MilanFostier1/Linefollower/technische tekeningen/mechanisch/Foto PCB 3D Bottom.png

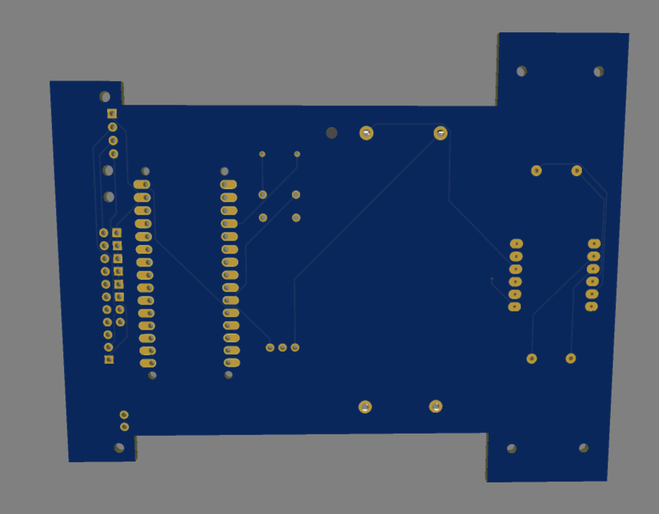
technische tekeningen/mechanisch/Foto PCB 3D Bottom.png
