MilanFostier1/Linefollower/technische tekeningen/mechanisch/Foto PCB 3D Top.png

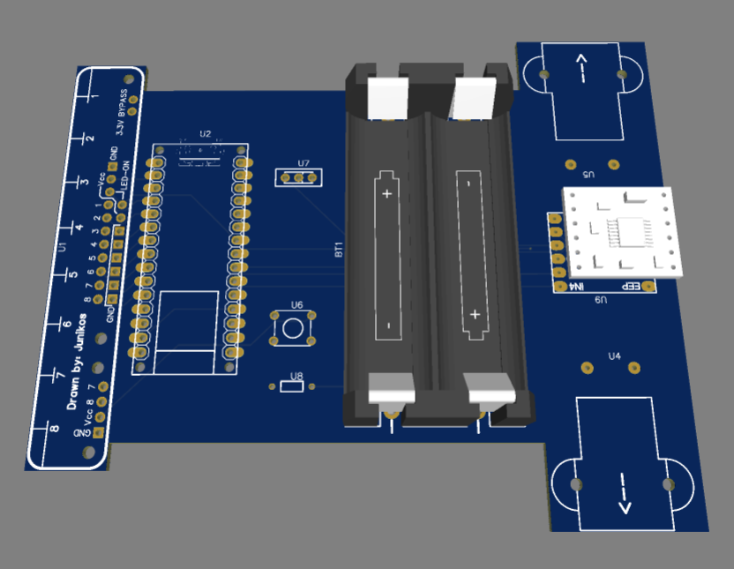
technische tekeningen/mechanisch/Foto PCB 3D Top.png
