MilanFostier1/Linefollower/bill of materials/readme.md

## bill of materials
<br />

|volgnummer|naam|omschrijving|nieuw/recup|kostprijs/stuk|aantal|subtotaal|
|---|----|---|---|---|---|---|
| 1 | Arduino® Nano ESP32 | Microcontroller | nieuw | €21.00 | 1 | €21.00 |
| 2 | DC motoren | 50:1 Micro Metal Gearmotor HP 6V | nieuw | €20.70 | 2 | €41.40 |
| 3 | Li-ion batterijen | 18650 Li-ion Oplaadbare Batterijen - 2200mAh 3.7V | nieuw | €12.68 | 2 | €25.36 |
| 4 | DRV8833 | H-brug | nieuw | €3.00 | 1 | €3.00 |
| 5 | QTR-8A | Sensor | nieuw | €11.19 | 1 | €11.19 |
| 6 | Wielen | Pololu Wheel 40×7mm Pair – Black | nieuw | €4.71 | 2 | €9.42 |
| 7 | Batterijhouder | 2 Slot Dubbele Serie 18650 Batterijhouder 7.4V DC | nieuw | €7.80 | 1 | €7.80 |
| 8 | Chassis | Experimenteer Prototyping Printplaat 9x15cm groen | nieuw | €2.25 | 1 | €2.25 |
| 9 | Batterijoplader | 2-Slots Batterijoplader 2x 18650 Oplaadbare Batterijen | nieuw | €10.69 | 1 | €10.69 |
| 10 | DC motoren beugel | Pololu Micro Metal Gearmotor Bracket Pair - Black | €nieuw | €2.54 | 1 | €2.54 |
| 10 | Draad | 40-aderig 2.54mm 28AWG Dupont per meter | nieuw | €3.90 | 1 | €3.90 |
| 11 | Schuifschakelaar | Schuifschakelaar SS12D00G2 3-pins | nieuw | €0.60 | 2 | €1.20 |
| 12 | Condensator 100µF | Condensator 100µF 16v Elektrolytisch zwart | nieuw | €1.10 | 1 | €1.10 |
| 13 | Schijfcondensator 100nF | keramische schijfcondensator 50V - 100nF | nieuw | €0.35 | 1 | €0.35 |
| 14 | Pin Header 40 Pin | 2.54Mm 40 Pin Ronde Vrouwelijke Socket Pin Header Strip 1X40p Zwart | nieuw | €1.00 | 2 | €2.00 |
| 15 | Pin Header 6 Pin | 6 Pin Female 11mm hoge stapelbare Pin Header Connector | nieuw | €0.50 | 2 | €1.00 |
| 16 | Li-ion batterijen | 18650 oplaadbare batterij 3.7V 2850Mah 10A | nieuw | €6.10 | 2 | €12.20 |
| 17 | Kabel | USB-A naar USB-C kabeltje 30cm kort zwart | nieuw | €2.15 | 1 | €2.15 |
