MilanFostier1/Linefollower/technische tekeningen/elektronisch/Schematic Syntheseproject.pdf

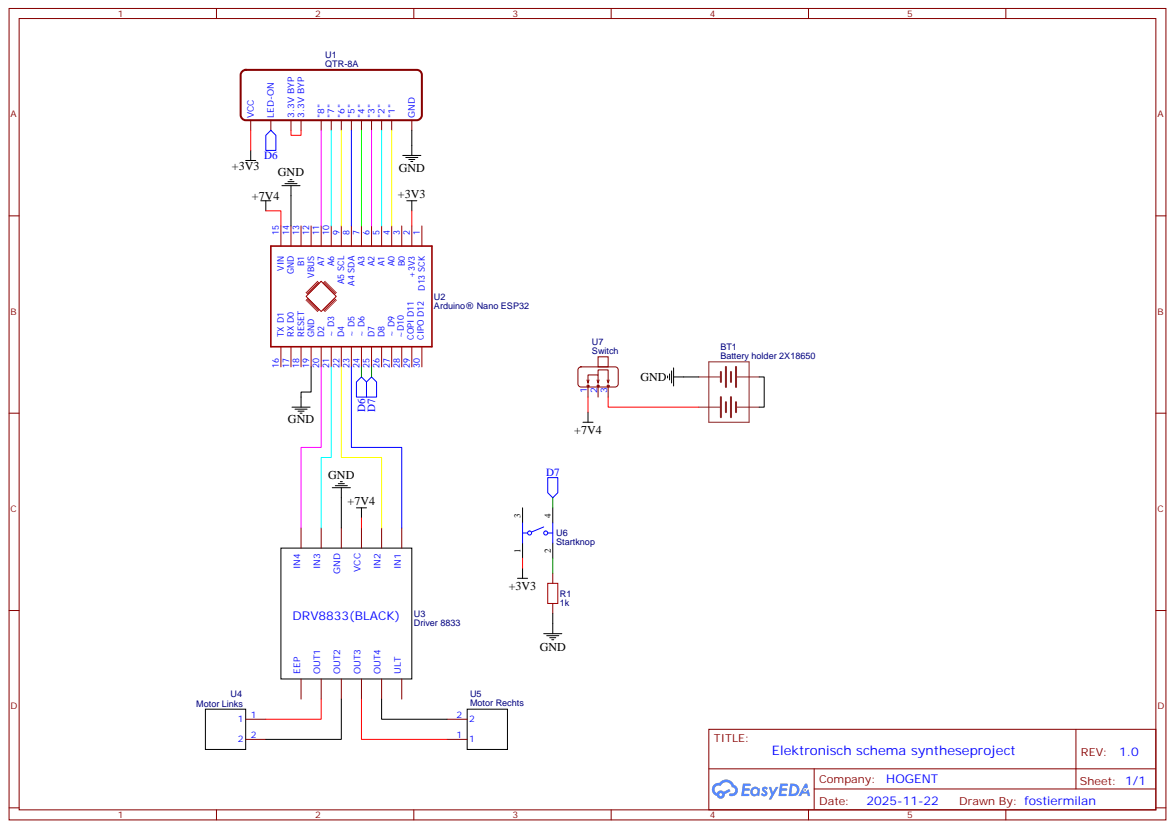
[picture p5: page 1]

9 A6 10 A7 11 VBUS 12 B1 13 GND 14 VIN 15 TX D1 16 RX D0 17 RESET 18 GND 19 D2 20 ~ D3 21 D4 22
