MilanFostier1/Linefollower/code/proof of concepts/hbridge/elektronisch schema h-brug.pdf

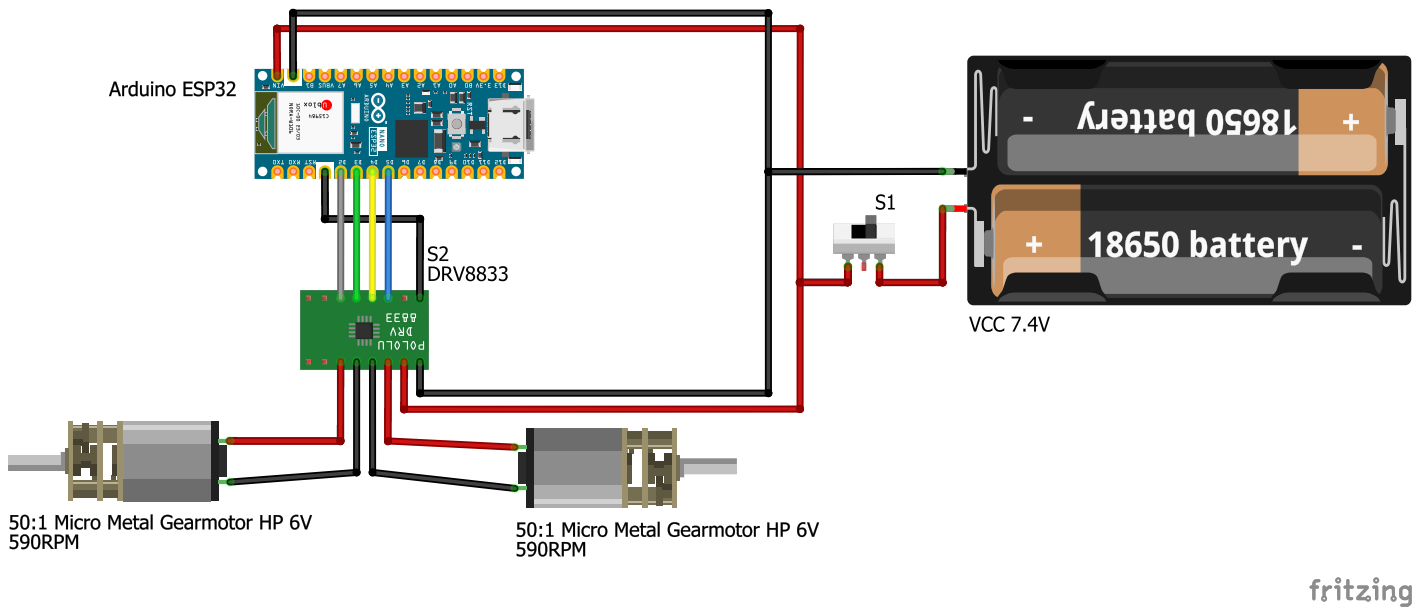
[picture p6: page 1]
