MilanFostier1/Linefollower/code/proof of concepts/sensor/elektronisch schema sensor.pdf

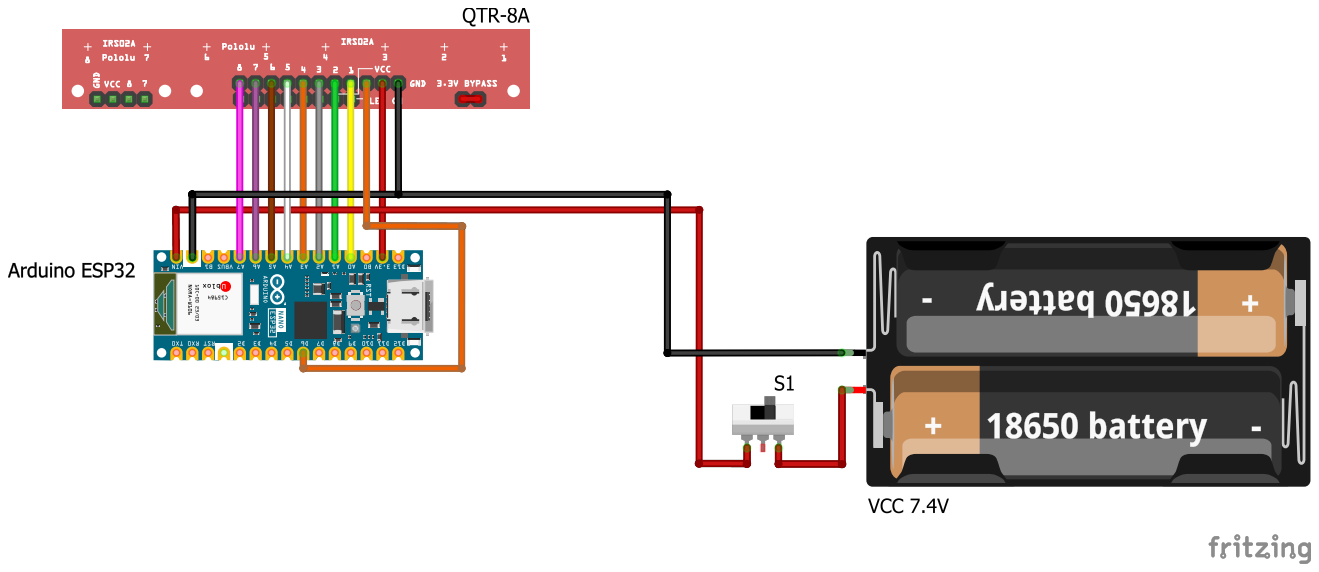
[picture p7: page 1]
