MilanFostier1/Linefollower/technische tekeningen/mechanisch/PCB Syntheseproject.pdf

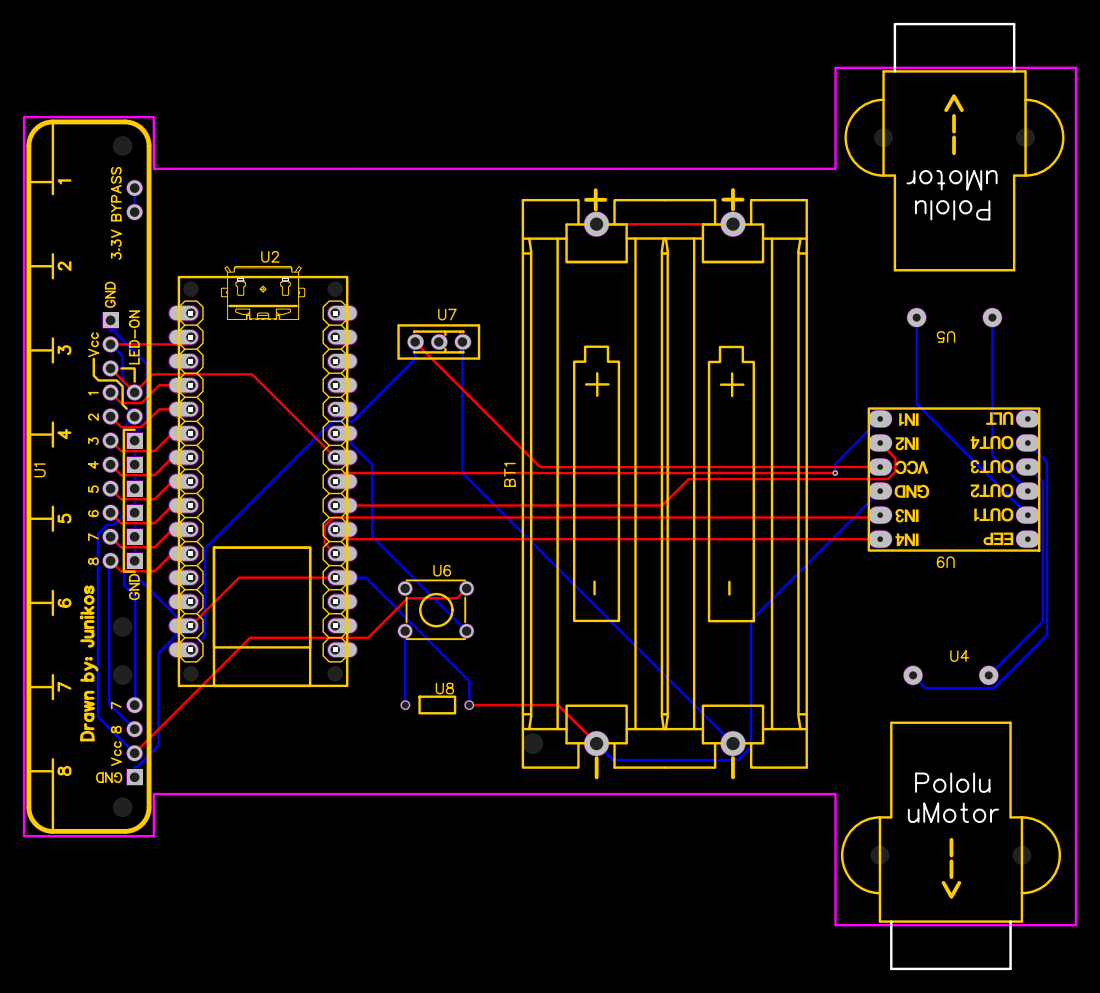
[picture p8: page 1]
