MilanFostier1/Linefollower/technische tekeningen/elektronisch/elektronisch schema.pdf

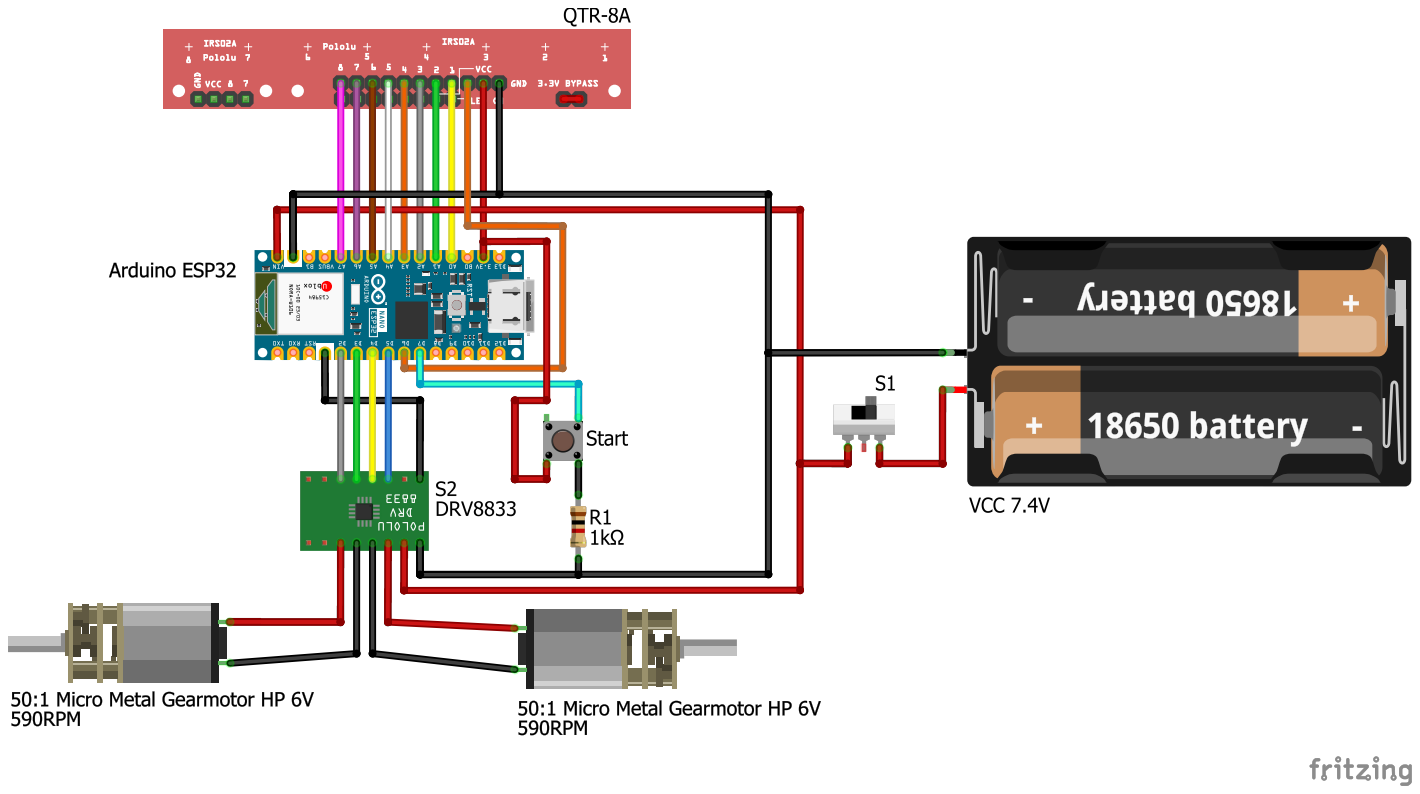
[picture p9: page 1]
